AyanBhardwaj1/OncoSense-MIT-LL/tools/analyze_session.py

#!/usr/bin/env python3
"""Summarize and plot OncoSense Band CSV sessions.

    python analyze_session.py data/*.csv               # summary table + plots
    python analyze_session.py data/*.csv --out figs    # choose plot directory

For hydration / surface-scan files it plots signal and score over time and
prints per-label statistics (mean, standard deviation, coefficient of
variation), which is how repeatability and dry-vs-moisturized separation are
judged. For spectral files it plots the mean 10-band spectrum per label.
"""

from __future__ import annotations

import argparse
import pathlib
import sys

try:
    import matplotlib

    matplotlib.use("Agg")
    import matplotlib.pyplot as plt
    import pandas as pd
except ImportError:  # pragma: no cover
    sys.exit("pandas and matplotlib are required:  pip install -r tools/requirements.txt")

BANDS = ["f415", "f445", "f480", "f515", "f555", "f590", "f630", "f680", "clear", "nir"]
WAVELENGTHS = {"f415": 415, "f445": 445, "f480": 480, "f515": 515, "f555": 555,
               "f590": 590, "f630": 630, "f680": 680, "nir": 910}


NUMERIC = ["t_ms", "gain", "signal", "ambient", "metric", "trend", "melanin_idx", "erythema_idx",
           *BANDS]


def load(paths: list[str]) -> pd.DataFrame:
    """Read session CSVs. Empty or unreadable files are skipped with a warning."""
    frames = []
    for p in paths:
        try:
            # Arduino's Serial.print writes "nan", "inf" or "ovf" for bad floats.
            df = pd.read_csv(p, comment="#", na_values=["nan", "inf", "-inf", "ovf"])
        except (pd.errors.EmptyDataError, pd.errors.ParserError, OSError) as err:
            print(f"warning: skipping {p}: {err}", file=sys.stderr)
            continue
        if df.empty:
            print(f"warning: skipping {p}: no data rows", file=sys.stderr)
            continue
        for col in NUMERIC:
            if col in df.columns:
                df[col] = pd.to_numeric(df[col], errors="coerce")
        if "label" not in df.columns:
            df["label"] = pathlib.Path(p).stem
        df["label"] = df["label"].astype(str)
        df["file"] = pathlib.Path(p).name
        frames.append(df)
    if not frames:
        return pd.DataFrame()
    return pd.concat(frames, ignore_index=True)


def group_name(mode: str, led: str, label: str) -> str:
    return f"{label} ({mode}, {led})"


def good_rows(df: pd.DataFrame) -> pd.DataFrame:
    if "flags" not in df.columns:
        return df
    return df[df["flags"].astype(str).str.fullmatch("OK")]


def summarize_scalar(df: pd.DataFrame, out: pathlib.Path) -> None:
    """Statistics per (mode, LED, label): different light sources never share a mean."""
    df = df.copy()
    df["group"] = [group_name(m, l, lab) for m, l, lab in zip(df["mode"], df["led"], df["label"])]
    ok = good_rows(df)
    dropped = len(df) - len(ok)
    stats = ok.groupby("group")["signal"].agg(["count", "mean", "std"])
    stats["cv_%"] = 100 * stats["std"] / stats["mean"]
    print("\nSignal by label, mode and LED (rows flagged NO_CONTACT / AMBIENT_LEAK / SATURATED excluded):")
    print(stats.round(5).to_string())
    if dropped:
        print(f"({dropped} flagged rows excluded)")

    # Cohen's d only between labels measured the same way (same mode and LED).
    for (mode, led), g in ok.groupby(["mode", "led"]):
        labels = list(dict.fromkeys(g["label"]))
        if len(labels) < 2:
            continue
        a, b = labels[0], labels[1]
        sa, sb = g[g.label == a]["signal"], g[g.label == b]["signal"]
        pooled = ((sa.var() + sb.var()) / 2) ** 0.5
        if pooled > 0:
            print(f"Separation {a} vs {b} ({mode}, {led}): Cohen's d = {(sb.mean() - sa.mean()) / pooled:.2f}")

    fig, axes = plt.subplots(2, 1, figsize=(9, 6), sharex=True)
    for (group, _file), g in df.groupby(["group", "file"]):
        t = (g["t_ms"] - g["t_ms"].iloc[0]) / 1000  # time from the start of each file
        axes[0].plot(t, g["signal"], ".-", label=group, ms=3)
        axes[1].plot(t, g["metric"], ".-", label=group, ms=3)
    axes[0].set_ylabel("signal (basic counts)")
    axes[1].set_ylabel("score / ratio")
    axes[1].set_xlabel("time (s)")
    axes[0].legend()
    for ax in axes:
        ax.grid(alpha=0.3)
    fig.suptitle("OncoSense session")
    fig.tight_layout()
    path = out / "session_timeseries.png"
    fig.savefig(path, dpi=150)
    plt.close(fig)
    print(f"\nSaved {path}")


def summarize_spectral(df: pd.DataFrame, out: pathlib.Path) -> None:
    ok = good_rows(df)
    bands = [b for b in BANDS if b in ok.columns and b != "clear"]
    means = ok.groupby("label")[bands].mean()
    print("\nMean reflectance by label:")
    print(means.round(4).to_string())
    if {"melanin_idx", "erythema_idx"} <= set(ok.columns):
        print("\nPigment indices:")
        print(ok.groupby("label")[["melanin_idx", "erythema_idx"]].agg(["mean", "std"]).round(2).to_string())

    fig, ax = plt.subplots(figsize=(8, 4.5))
    x = [WAVELENGTHS[b] for b in bands]
    for label, row in means.iterrows():
        ax.plot(x, row.values, "o-", label=label)
    ax.set_xlabel("band centre (nm)")
    ax.set_ylabel("reflectance (vs white card)")
    ax.grid(alpha=0.3)
    ax.legend()
    fig.tight_layout()
    path = out / "session_spectrum.png"
    fig.savefig(path, dpi=150)
    plt.close(fig)
    print(f"\nSaved {path}")


def main() -> int:
    ap = argparse.ArgumentParser(description=__doc__, formatter_class=argparse.RawDescriptionHelpFormatter)
    ap.add_argument("files", nargs="+")
    ap.add_argument("--out", default="figures")
    args = ap.parse_args()

    out = pathlib.Path(args.out)
    out.mkdir(parents=True, exist_ok=True)
    df = load(args.files)
    if df.empty or "mode" not in df.columns:
        print("error: no data rows in the given files", file=sys.stderr)
        return 1
    modes = set(df["mode"].dropna().unique())

    if "spectral" in modes:
        summarize_spectral(df[df["mode"] == "spectral"], out)
    scalar = df[df["mode"].isin(["hydration", "scan"])]
    if len(scalar):
        summarize_scalar(scalar, out)
    return 0


if __name__ == "__main__":
    raise SystemExit(main())
