AyanBhardwaj1/OncoSense-MIT-LL/(commit log)

2026-10-26 Reorganize repository and add project photos and concept sketches
    Move the original v1 sketches into firmware/legacy, convert product photos
    to web-sized JPEGs under docs/images, and add prototype photos and concept
    sketches from the final presentation.
2026-10-26 Add firmware v2 with differential sensing, calibration and tests
    Single modular firmware with hydration, surface-scan and spectral modes.
    Adds LED on/off ambient rejection, auto-gain with saturation retry,
    per-user two-point calibration, contact and light-leak flags, CSV output,
    a non-blocking serial start and a configurable I2C bus. Signal models are
    unit-tested on the host and the firmware is compiled in CI.
2026-10-26 Rewrite README and add engineering documentation and portfolio
    Background, literature review (with PDF), optics theory, design process,
    testing and results, calibration guide, roadmap, hardware BOM and wiring
    diagram, and a one-page engineering portfolio.
2026-10-27 fix: harden calibration and auto-gain in firmware v2
    - Trend is NaN (not 0) until the first valid sample
    - Auto-gain retries down to the lowest gain before flagging SATURATED
    - White reference rejects frames with no target or saturation and needs
    half the captures to be good; bands with no reference report NaN
    - Warn when dry/moisturized references are too close to score between,
    and when switching LED discards references
    Found by independent code review; covered by new unit tests.
2026-10-27 test: run the real firmware in a hardware simulator
    Compiles firmware/OncoSense unmodified against simulated Arduino, AS7341
    and flash with a virtual clock, and drives it through serial commands:
    calibration, auto-gain, flags, ambient rejection, CSV structure, and an
    end-to-end firmware -> logger -> analyzer pipeline.
2026-10-27 fix: make the logger and analyzer robust to real sessions
    Logger: testable Session class, label sanitised for file names, asks for
    a fresh header when data arrives without one, non-zero exit when nothing
    was recorded. Analyzer: skips empty files, parses Arduino nan/ovf tokens,
    never mixes modes or LEDs in one statistic, time per file, non-zero exit
    on no data. Adds pytest coverage (95%) including main() with a fake port.
